yavuz650/RISC-V/README.md

# Hornet RISC-V Core
Hornet is a simple, fully open-source, FPGA-proven 32-bit RISC-V core.

## Highlights
* RV32IM instructions
* Machine mode support
* 5-stage pipelined microarchitecture
* Misaligned access support
* FPGA proven

In this repo, in addition to the core itself, you can also find supporting peripherals, software and SoC examples to help you get started.

We also provide a reference manual that explains how the core is designed and how it works, in detail; and a user guide that describes how
you can use the core.

|<span style="font-size:1.5em;">Simplified Pipeline Diagram</span>
|:---:
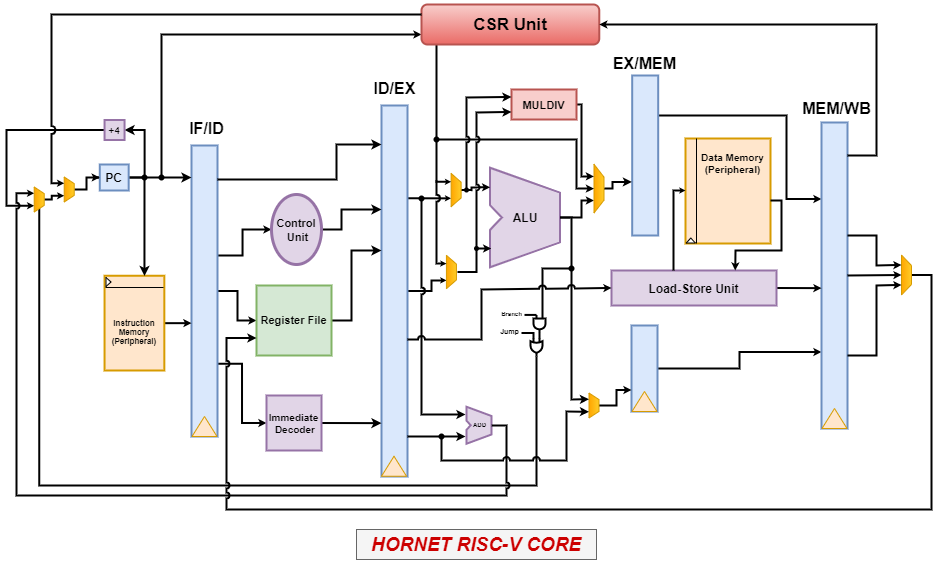
[picture p1: simplified_pipeline.png]
Simplified Pipeline Diagram
| |

## Troubleshooting, Bugs & Suggestions
Feel free to create an issue on GitHub or send an e-mail.
* 0yavuz0@gmail.com
* yasinxyilmaz@gmail.com
