yavuz650/RISC-V/documentation/complete_pipeline_diagram.pdf

## CSR Unit

CSR W Addr. In | Forwarding Unit

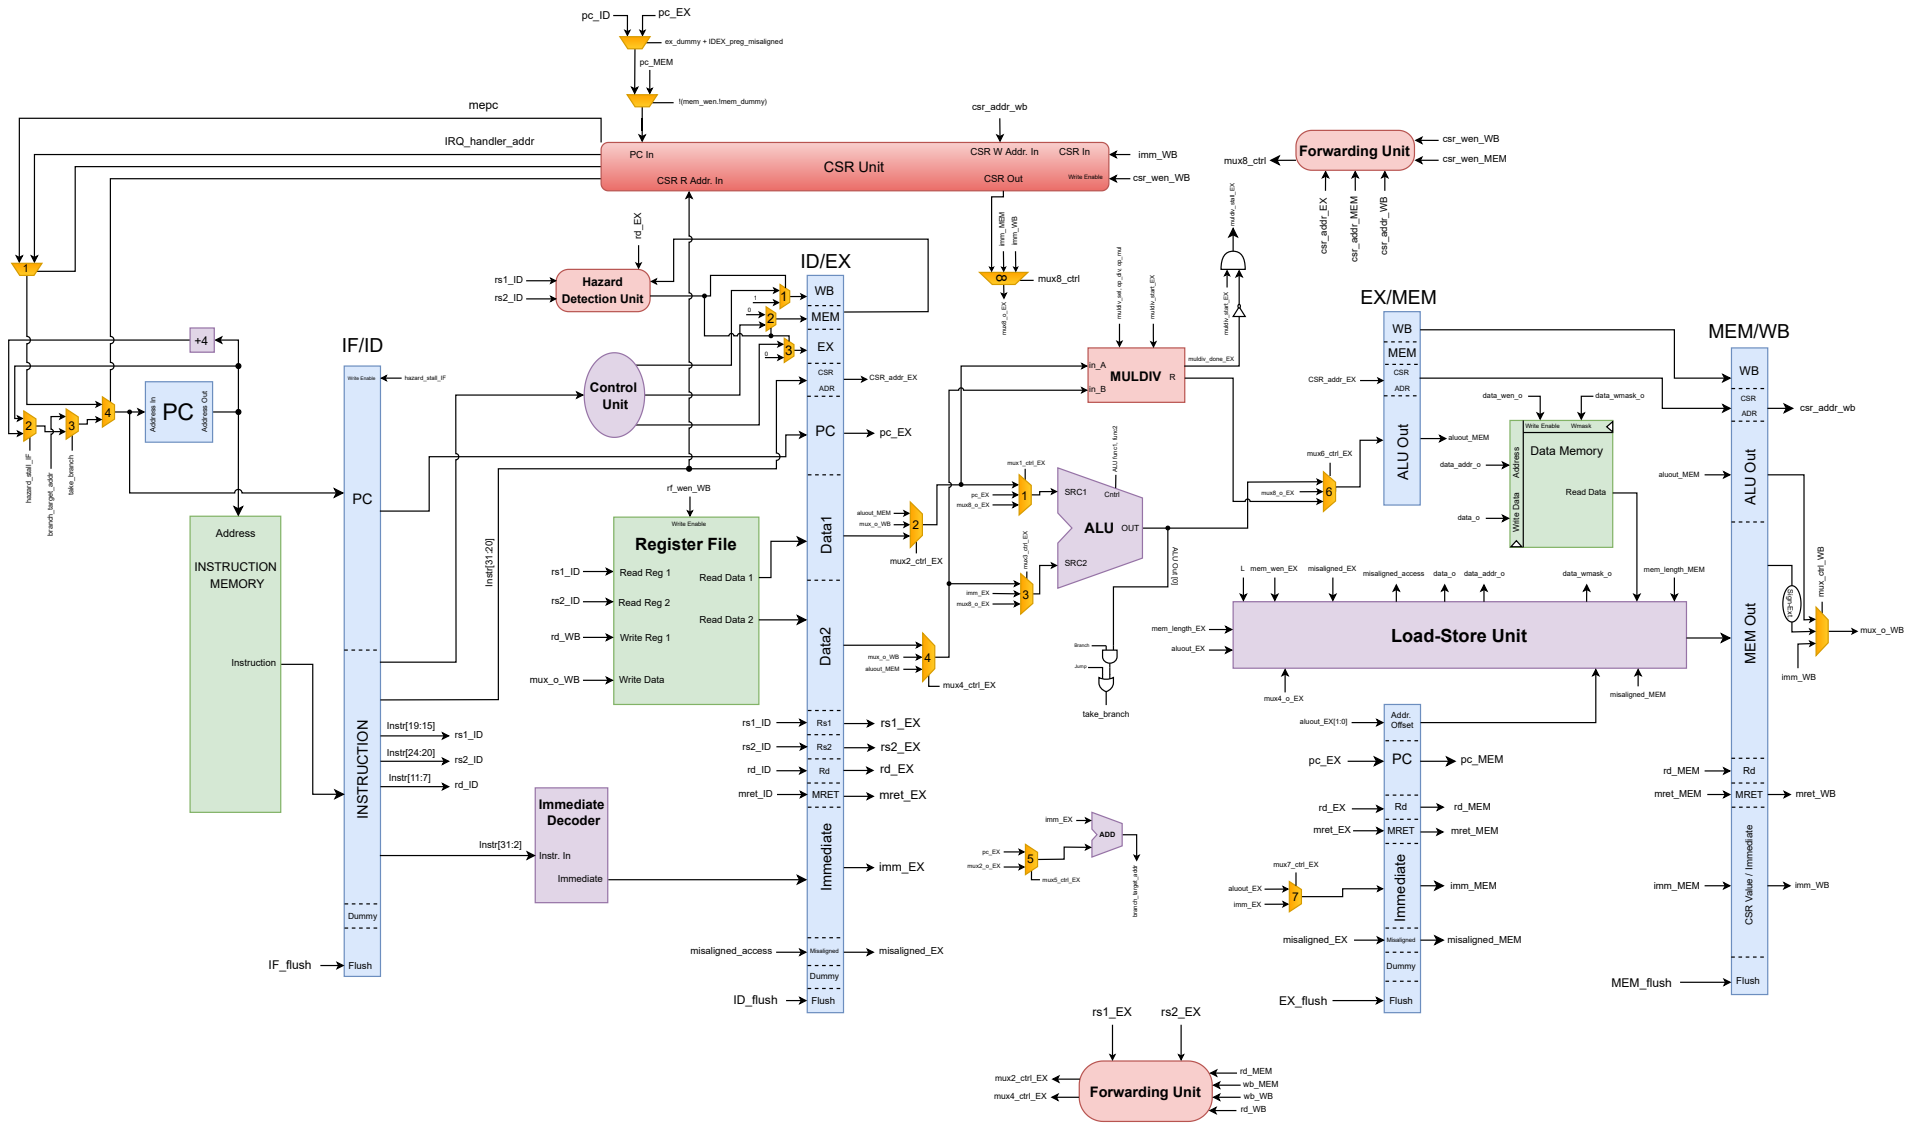
[picture p5: page 1]
INSTRUCTION MEMORY; PCINSTRUCTION; Address; Instruction; EX/MEM; MEM/WB; Register File; Read Reg 1; Read Reg 2; Write Reg 1; Write Data; Read Data 1; Read Data 2; Write Enable; Immediate Decoder; Instr. In; Control Unit; PCData2 Data1; Rs2 Rd Immediate; MEM; ALU; SRC1; SRC2; OUT; Branch; Jump; Cntrl; ADD; WB MEMImmediate; RdALU Out; Data Memory; Read Data; WBMEM Out; Instr[31:2]; Forwarding Unit; Immediate; Hazard; Detection Unit; Address In; Address Out; ALU Out [0]; Wmask; Flush; CSR Out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

CSR R Addr. In

Load-Store Unit

CSR Value / Immediate
