yavuz650/RISC-V/(commit log)

2021-02-13 added the priviliged architecture
    this design can handle external interrupts.
2021-02-18 updated csr machine.
    csr machine can handle external and timer interrupts. memory module is more generic now.
2021-02-27 fixed redundant stalling
2021-02-27 support for misaligned access
    [core.v, csr_unit.v, top_module.v]
2021-03-23 Added software libraries.
    Added an irq header that contains basic interrupt enable/disable functions. Added a simple UART driver.
2021-03-24 Added a uart module.
2021-03-24 Added the loader module.
    This module is responsible for controlling the reset inputs of the core. It is used for programming the core through uart.
2021-03-24 Added a new reset signal.
    Added hard reset and soft reset signals. Each reset signal sets the mcause register to a different value.
    [core.v, csr_unit.v]
2021-03-29 Added direct mode interrupts.
    Added direct mode interrupts. Fixed IRQ handler address calculation.
    [csr_unit.v]
2021-03-29 Added support for direct mode.
    Added support for direct mode interrupts. Fixed mtvec value calculation.
2021-03-29 Added a new test.
    Added a test program for direct mode interrupts.
2021-04-19 Added FPGA specific signals.
    Added a clock wizard instantiation. Specific for Arty-S7 FPGA board.
2021-04-19 Added FPGA constraints file.
    Added Arty-S7 FPGA board constraints.
2021-04-29 Added fast interrupts
2021-04-30 Added weak functions
    Replaced previous function definitions with weak functions. This allows the user to override the interrupt handler functions.
2021-04-30 Transition to fast interrupts.
    bootloader and aes_main now use a fast interrupt instead of the external interrupt.
2021-05-18 Added time out failure.
    Tests will print failure when a time out occurs.
2021-05-22 Improved direct mode test.
    Automated and improved the direct mode interrupt test.
2021-05-24 Fixed arithmetic shift right.
    [ALU.v]
2021-05-24 Fixed a minor bug.
    [control_unit.v]
2021-07-03 Remove reset signals.
    Removed one of the reset signals. We are now back to using a single reset signal. When programming the core, a memory-mapped register is used to determine the reset cause, instead of mcause.
    [core.v, csr_unit.v]
2021-07-03 Use onboard UART
    Use the onboard USB-to-UART of ARTY S7 board.
2021-07-17 Added wishbone stall
    Added wishbone stall signal. Also fixed indentations.
    [core_wb.v]
2021-07-17 Reorganized stall signals
2021-07-17 Fixed address bit selection
    [memory_2rw_wb.v]
2021-07-18 Fixed number of slaves
    [fpga_top.v]
2021-08-02 Removed CSR forwarding.
    Removed CSR forwarding logic to improve critical path. Instead of forwarding, pipeline is stalled when a CSR dependency occurs. CSR dependencies are rare, so this won't have a significant impact on performance.
    [forwarding_unit.v]
2021-08-02 Improved timing.
    Removed CSR forwarding mux.
    Separated CSR arithmetic from ALU.
    Removed reset from WB mux.
    [core.v]
2021-08-02 Fix reset output signal.
    Reset output is now driven by a register, instead of a combinational logic. As the reset signal drives asynchronous reset pins of registers, combinational logic can glitch and cause unwanted resets.
    Also removed a redundant led output.
    [loader_wb.v]
